iorodeo/iorodeo_feather_tripler_enc1/README.md

# IO Rodeo's iorodeo_feather_tripler_enc1  

Hardware files for IO Rodeo's iorodeo_feather_tripler_enc1. (In progress)

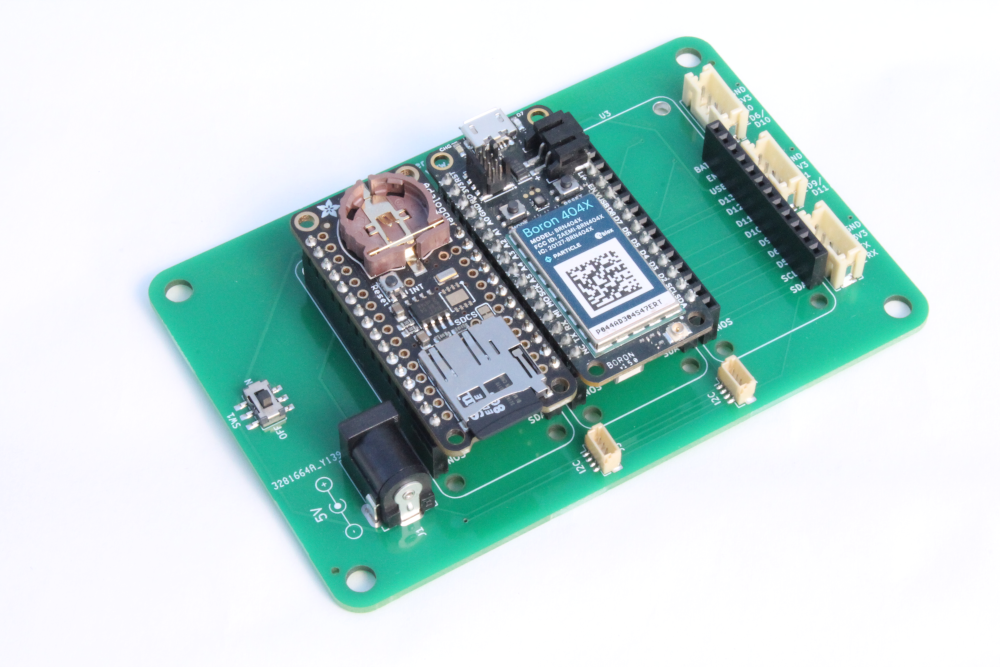
[picture p1: images/feather_tripler_pcb_adalogger_boron_1.png]
Feather Tripler Enc1 Image #1
