iorodeo/iorodeo_feather_tripler_enc1/images/feather_tripler_enclosure_2.png

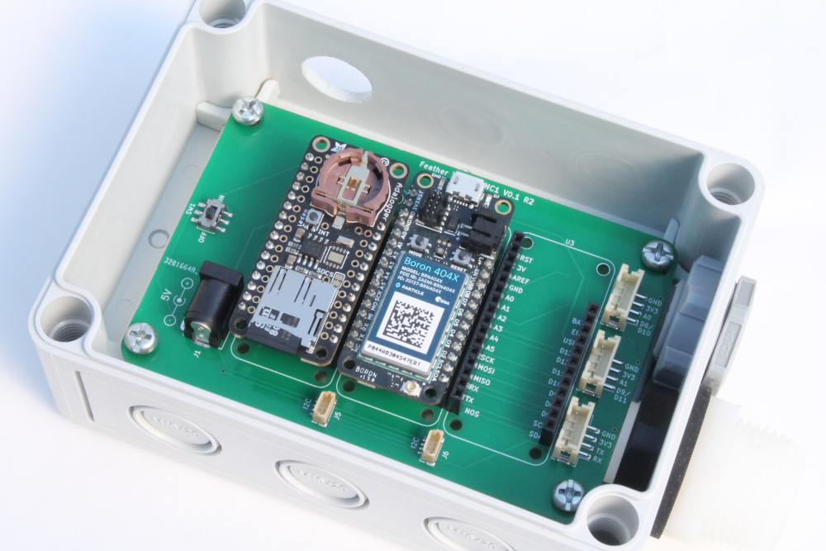
images/feather_tripler_enclosure_2.png
