iorodeo/iorodeo_feather_tripler_enc1/images/feather_tripler_enclosure_3.png

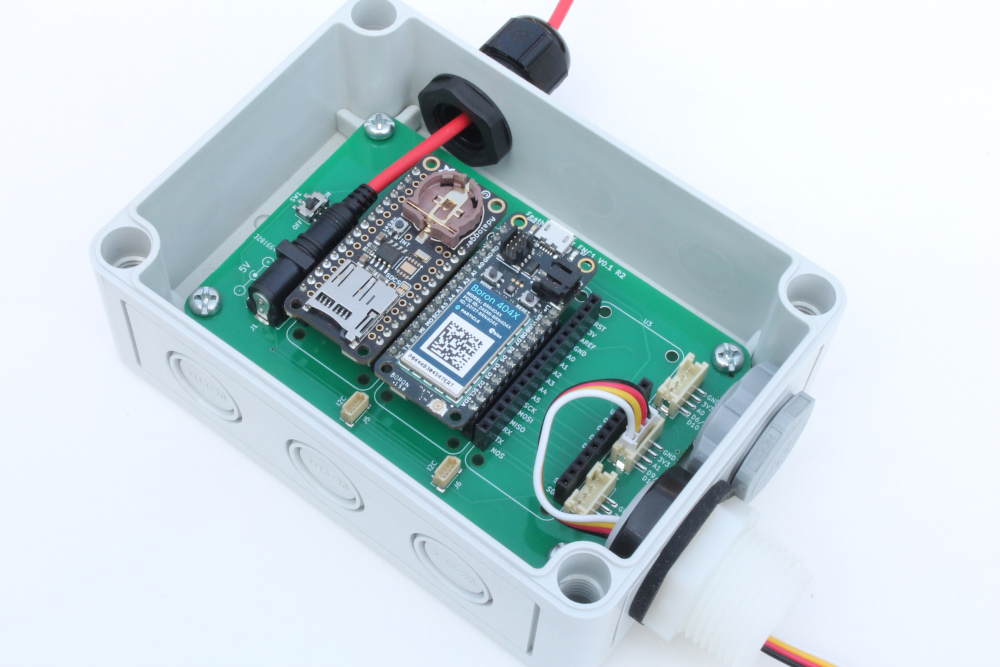
images/feather_tripler_enclosure_3.png
