iorodeo/iorodeo_feather_tripler_enc1/images/feather_tripler_pcb_front_1.png

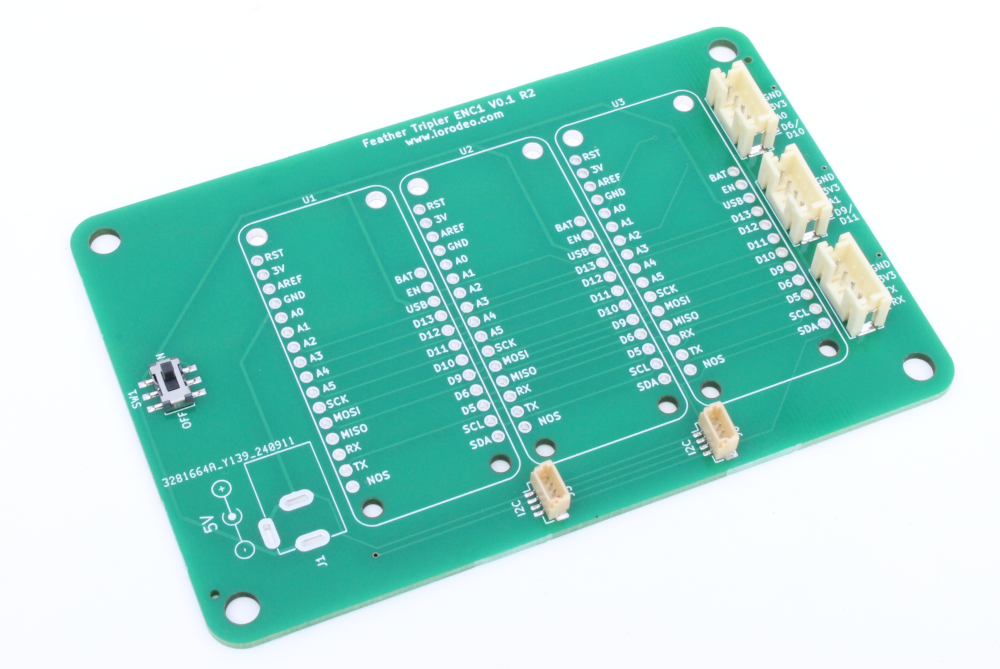
images/feather_tripler_pcb_front_1.png
