iorodeo/iorodeo_feather_tripler_enc1/kicad/BOM.xlsx

Feather Tripler PCB through hole components (hand solder) | Notes | Category | Vendor | Part # | Quantity | URL
Feather Header Kit | female headers for mounting feather/featherwings | Tripler PCB | Adafruit | 2886 | 3 | https://www.adafruit.com/product/2886
DC Power Connector | for connecting power from solar panel | Tripler PCB | Mouser | 490-PJ-035C | 1 | https://www.mouser.com/ProductDetail/490-PJ-035C
Feather Tripler PCB through SMT components (pre-assembled) * | Notes | Category | Vendor | Part # | Quantity | URL
PCB Switch | smt power switch | Tripler PCB | LCSC | C963205 | 1 | https://www.lcsc.com/product-detail/Slide-Switches_G-Switch-MS-22D28-G020_C963205.html
JST PH vertical 4-pin | Grove connectors | Tripler PCB | LCSC | C160354 | 3 | https://www.lcsc.com/product-detail/Wire-To-Board-Connector_JST-B4B-PH-SM4-TB-LF-SN_C160354.html
JST SH vertical 4-pin | stemma/qwiic connectors | Tripler PCB | LCSC | C160390 | 2 | https://www.lcsc.com/product-detail/Wire-To-Board-Connector_JST-BM04B-SRSS-TB-LF-SN_C160390.html
Polycase enclosure parts | Notes | Category | Vendor | Part # | Quantity | URL
SK-15 Enclosure with Knockouts | enclosure for electronics | Polycase | Polycase | SK-15-02 | 1 | https://www.polycase.com/sk-15
SK-99 Mounting Kit for SK Series Enclosures | feet for mounting enclosure | Polycase | Polycase | SK-99 | 1 | https://www.polycase.com/sk-99
SK-97 Spacer Kit for SK Series Enclosures | spacer kit for mounting PCB inside enclosure | Polycase | Polycase | SK-97 | 1 | https://www.polycase.com/sk-97
Vent Plug |  | Polycase | Polycase | UA-006 | 1 | https://www.polycase.com/ua-006
External solar power | Notes | Category | Vendor | Part # | Quantity | URL
5 Watt 5 Volt 35Wh Solar System | voltaic solar panel/battery combo | Electronics | Voltaic | K-P105-V35IoT | 1 | https://voltaicsystems.com/5-watt-5-volt-35wh-solar-system/
Plastic Submersible Cord Grip for 0.13"-0.27" Cord OD, for M16 Knockout | waterproof cable entry | Polycase | mcmaster | 7310K52 | 1 | https://www.mcmaster.com/7310K52/
Compatible cables (examples) | Notes | Category | Vendor | Part # | Quantity | URL
Grove cable, 4pos, 20cm, 5pack | used to connect sensors with analog output, e.g., maxsonar to PCB | Tripler PCB | Digikey | 2221-A034-B-ND | 1 | https://www.digikey.com/en/products/detail/m5stack-technology-co-ltd/A034-B/16370068
Stemma Qt/Qwiic cable 50mm long | used for optional i2c sensors | Tripler PCB | Adafruit | 4399 | 1 | https://www.adafruit.com/product/4399
Additional parts for Open water level sensor (https://github.com/COAST-Lab/Open-Water-Level) | Notes | Category | Vendor | Part # | Quantity | URL
Maxbotix Ultrasonic Rangefinder MB7092 XL-MaxSonar-WRMA1 | distance sensor | Electronics | Adafruit | 1137 | 1 | https://www.adafruit.com/product/1137
Adalogger RTC + SD Add-on For All Feather Boards | for data logging | Electronics | Adafruit | 2922 | 1 | https://www.adafruit.com/product/2922
SD/MicroSD Memory Card (8 GB SDHC) | disk for data logging | Electronics | Adafruit | 1294 | 1 | https://www.adafruit.com/product/1294
BORON LTE CAT-M1 (NORAM) WITH ET | MCU, cell modem, power management, cellular communications | Electronics | Digikey | 1878-BRN404X-ND | 1 | https://www.digikey.com/en/products/detail/particle-industries-inc/BRN404X/17632424
Plastic pipe fitting straight connector with hex body, 3/4 NPT Female | for mounting sonar to polycase enclosure | Polycase | mcmaster | 48335K143 | 1 | https://www.mcmaster.com/48335K143/
Plastic pipe fitting reducer with hex nody, 3/4 NPT male x 1/2 NPT male | for mounting sonar to polycase enclosure | Polycase | mcmaster | 48335K167 | 1 | https://www.mcmaster.com/48335K167/
1/2 NPT black locknut for continuous-flex Plastic conduit fitting | for mounting sonar to polycase enclosure | Polycase | mcmaster | 3185K112 | 1 | https://www.mcmaster.com/3185K112/
Gasket Washer, $7.22 pack of 25 | for mounting sonar to polycase enclosure | Polycase | mcmaster | 5456K21 | 1 | https://www.mcmaster.com/5456K21/
IO Rodeo XL MaxSonar adapter PCB ** | for connecting cable to sonar distance sensor |  | IO Rodeo |  | 1 | https://github.com/iorodeo/xl_maxsonar_adapter
* gerber and fab files for automated assembly can be found in the “kicad/produciton” sub-directory.
** see xl_maxsonar_adapter repository for adapter PCB BOM
