iorodeo/iorodeo_feather_tripler_enc1/kicad/production/v0p1_r1/BOM_JLCPCB_feather_tripler_enc1_v0p1r1.xlsx

Comment | Designator | Footprint | LCSC Part #（optional） | Qty
SMD Slide Switch | SW1 | SMD | C963205 | 1
JST PH 4-pin connector vertical, B4B-PH-SM4-TB(LF)(SN) | J2,J3,J4 | SMD,P=2mm | C160354 | 3
JST SH 4-pin connector vertical, BM04B-SRSS-TB(LF)(SN) | J5,J6 | SMD,P=1mm | C160390 | 2
