iorodeo/iorodeo_feather_tripler_enc1/kicad/iorodeo_feather_tripler_enc1.step

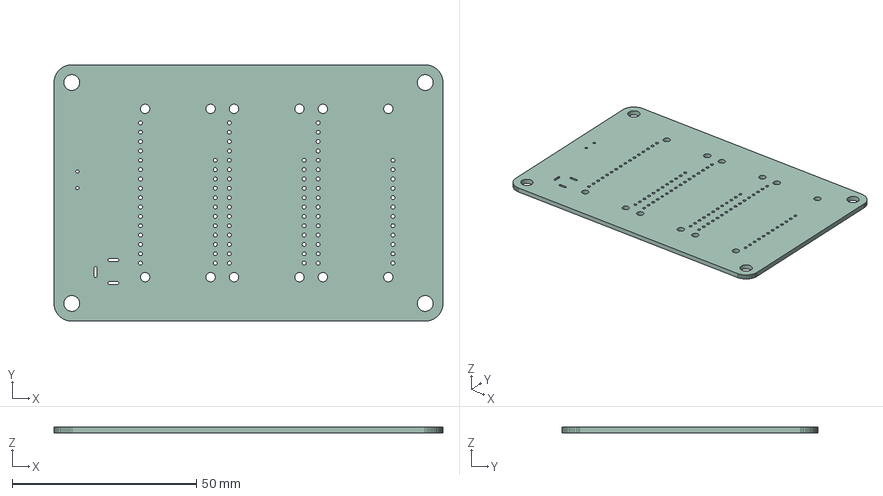
[picture p8: CAD file, 2024-09-08]
kicad/iorodeo_feather_tripler_enc1.step
105.7 x 69.6 x 1.60 mm
