iorodeo/iorodeo_feather_tripler_enc1/(list of files, drawings)

Other design files:
kicad/iorodeo_feather_tripler_enc1.dsn
