iorodeo/iorodeo_feather_tripler_enc1/kicad/iorodeo_feather_tripler_enc1.kicad_pcb

## KiCad design kicad/iorodeo_feather_tripler_enc1.kicad_pcb (2024-09-09)

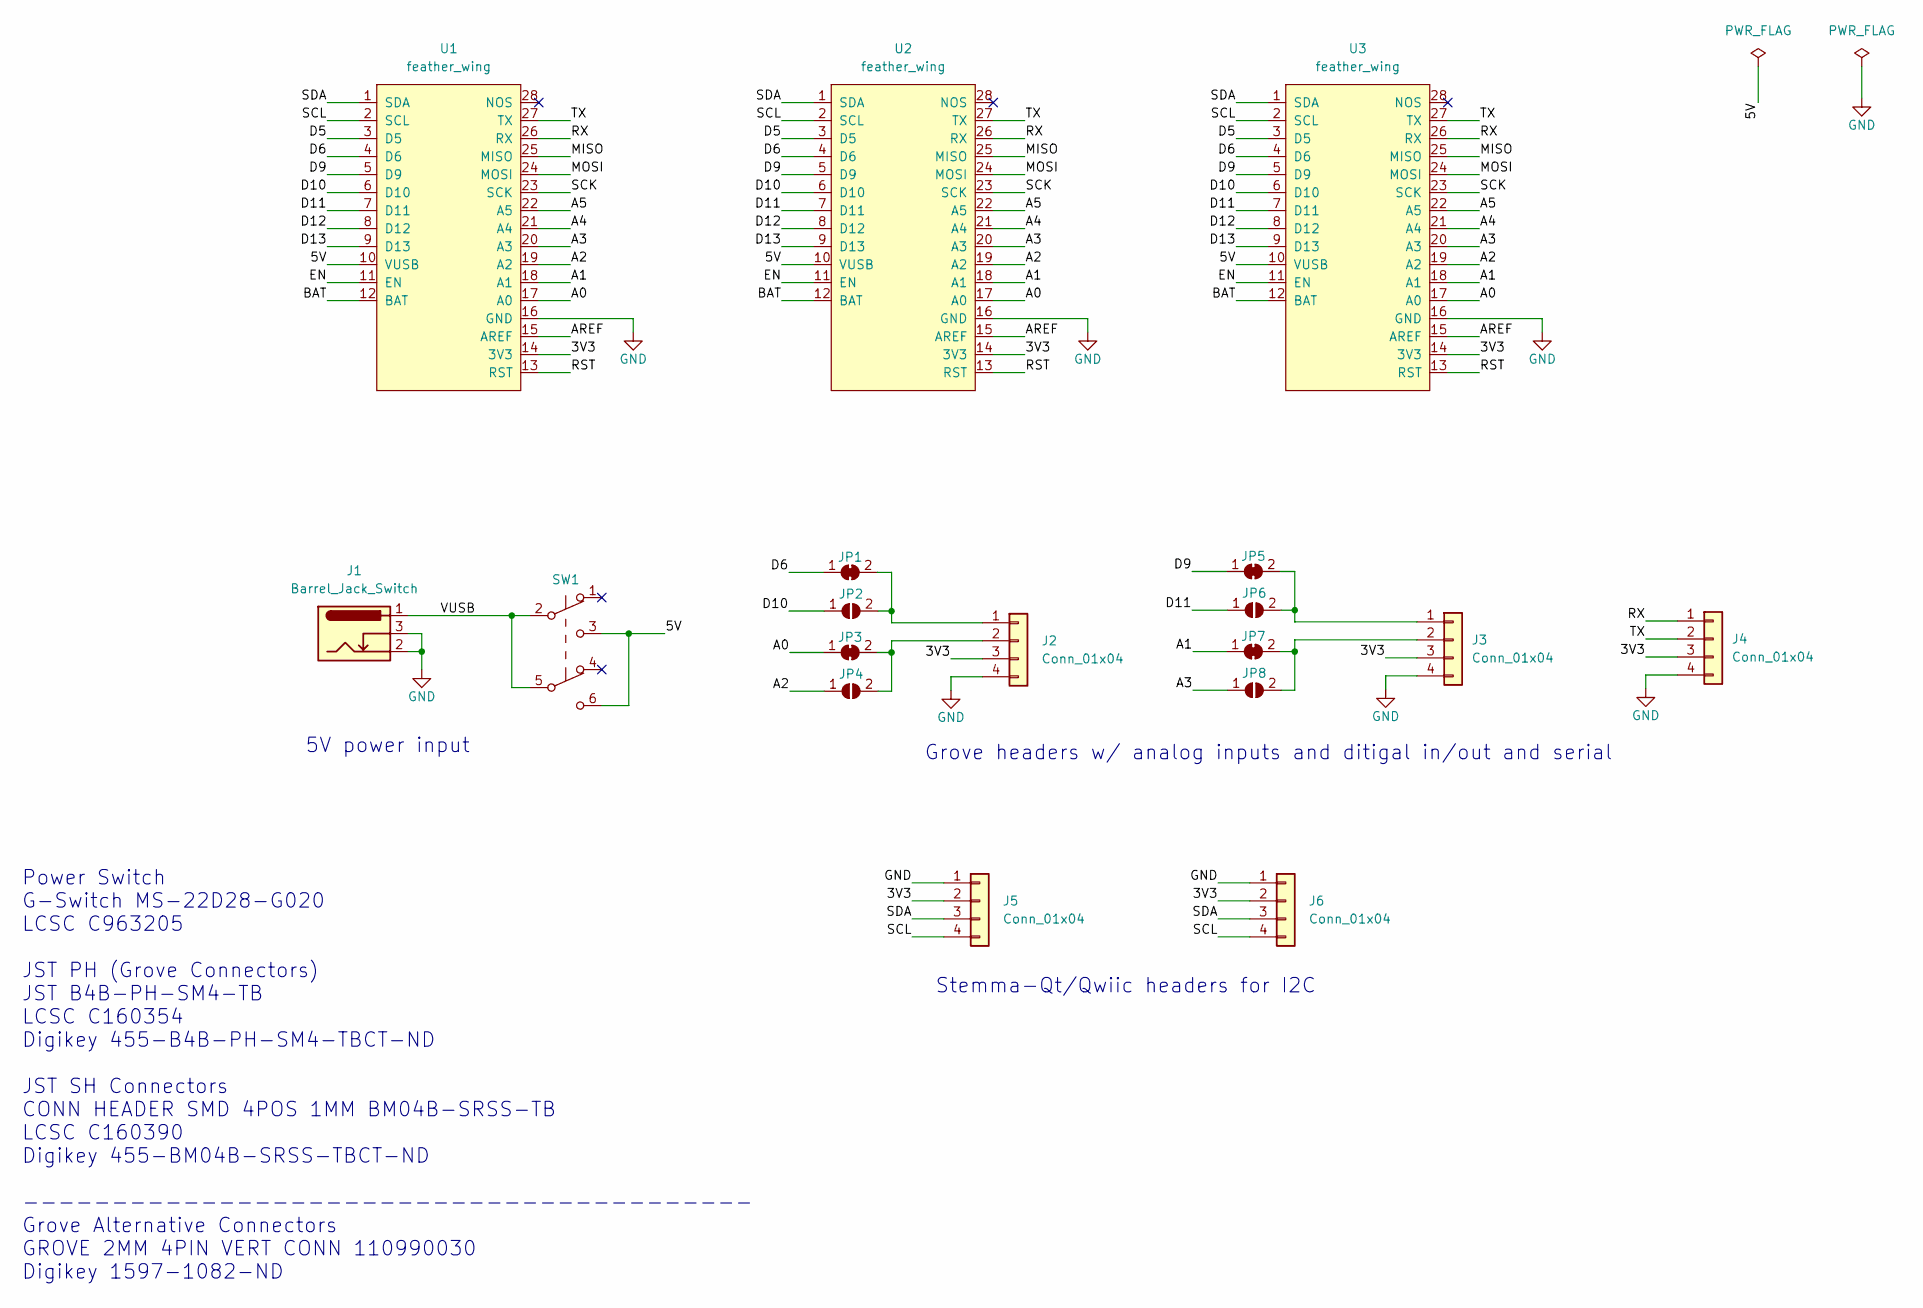
[picture p9: schematic iorodeo_feather_tripler_enc1.kicad_sch]

Parts:
J1: Barrel_Jack_Switch; CUI_PJ-035C
J2, J3, J4: Conn_01x04; JST_PH_B4B-PH-SM4-TB_1x04-1MP_P2.00mm_Vertical
J5, J6: Conn_01x04; JST_SH_BM04B-SRSS-TB_1x04-1MP_P1.00mm_Vertical
JP1, JP3, JP5, JP7: SolderJumper_2_Bridged; SolderJumper-2_P1.3mm_Bridged_RoundedPad1.0x1.5mm
JP2, JP4, JP6, JP8: SolderJumper_2_Open; SolderJumper-2_P1.3mm_Open_RoundedPad1.0x1.5mm
SW1: SW_Push_DPDT; MS-22D28-G020
U1, U2, U3: feather_wing

Connections:
/3V3: J2.3, J3.3, J4.3, J5.2, J6.2, U1.14 (3V3), U2.14 (3V3), U3.14 (3V3)
/5V: SW1.3 (C), SW1.6 (C), U1.10 (VUSB), U2.10 (VUSB), U3.10 (VUSB)
/A0: JP3.1 (A), U1.17 (A0), U2.17 (A0), U3.17 (A0)
/A1: JP7.1 (A), U1.18 (A1), U2.18 (A1), U3.18 (A1)
/A2: JP4.1 (A), U1.19 (A2), U2.19 (A2), U3.19 (A2)
/A3: JP8.1 (A), U1.20 (A3), U2.20 (A3), U3.20 (A3)
/A4: U1.21 (A4), U2.21 (A4), U3.21 (A4)
/A5: U1.22 (A5), U2.22 (A5), U3.22 (A5)
/AREF: U1.15 (AREF), U2.15 (AREF), U3.15 (AREF)
/BAT: U1.12 (BAT), U2.12 (BAT), U3.12 (BAT)
/D5: U1.3 (D5), U2.3 (D5), U3.3 (D5)
/D6: JP1.1 (A), U1.4 (D6), U2.4 (D6), U3.4 (D6)
/D9: JP5.1 (A), U1.5 (D9), U2.5 (D9), U3.5 (D9)
/D10: JP2.1 (A), U1.6 (D10), U2.6 (D10), U3.6 (D10)
/D11: JP6.1 (A), U1.7 (D11), U2.7 (D11), U3.7 (D11)
/D12: U1.8 (D12), U2.8 (D12), U3.8 (D12)
/D13: U1.9 (D13), U2.9 (D13), U3.9 (D13)
/EN: U1.11 (EN), U2.11 (EN), U3.11 (EN)
/MISO: U1.25 (MISO), U2.25 (MISO), U3.25 (MISO)
/MOSI: U1.24 (MOSI), U2.24 (MOSI), U3.24 (MOSI)
/RST: U1.13 (RST), U2.13 (RST), U3.13 (RST)
/RX: J4.1, U1.26 (RX), U2.26 (RX), U3.26 (RX)
/SCK: U1.23 (SCK), U2.23 (SCK), U3.23 (SCK)
/SCL: J5.4, J6.4, U1.2 (SCL), U2.2 (SCL), U3.2 (SCL)
/SDA: J5.3, J6.3, U1.1 (SDA), U2.1 (SDA), U3.1 (SDA)
/TX: J4.2, U1.27 (TX), U2.27 (TX), U3.27 (TX)
/VUSB: J1.1, SW1.2 (B), SW1.5 (B)
GND: J1.2, J1.3, J2.4, J3.4, J4.4, J5.1, J6.1, U1.16 (GND), U2.16 (GND), U3.16 (GND)
unnamed: J2.1, JP1.2 (B), JP2.2 (B)
unnamed: J2.2, JP3.2 (B), JP4.2 (B)
unnamed: J3.1, JP5.2 (B), JP6.2 (B)
unnamed: J3.2, JP7.2 (B), JP8.2 (B)

Notes on the sheet:
Power Switch G-Switch MS-22D28-G020 LCSC C963205 JST PH (Grove Connectors) JST B4B-PH-SM4-TB LCSC C160354 Digikey 455-B4B-PH-SM4-TBCT-ND JST SH Connectors CONN HEADER SMD 4POS 1MM BM04B-SRSS-TB LCSC C160390 Digikey 455-BM04B-SRSS-TBCT-ND ----------------------------------------- Grove Alternative C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
Grove headers w/ analog inputs and ditigal in/out and serial
5V power input
Stemma-Qt/Qwiic headers for I2C

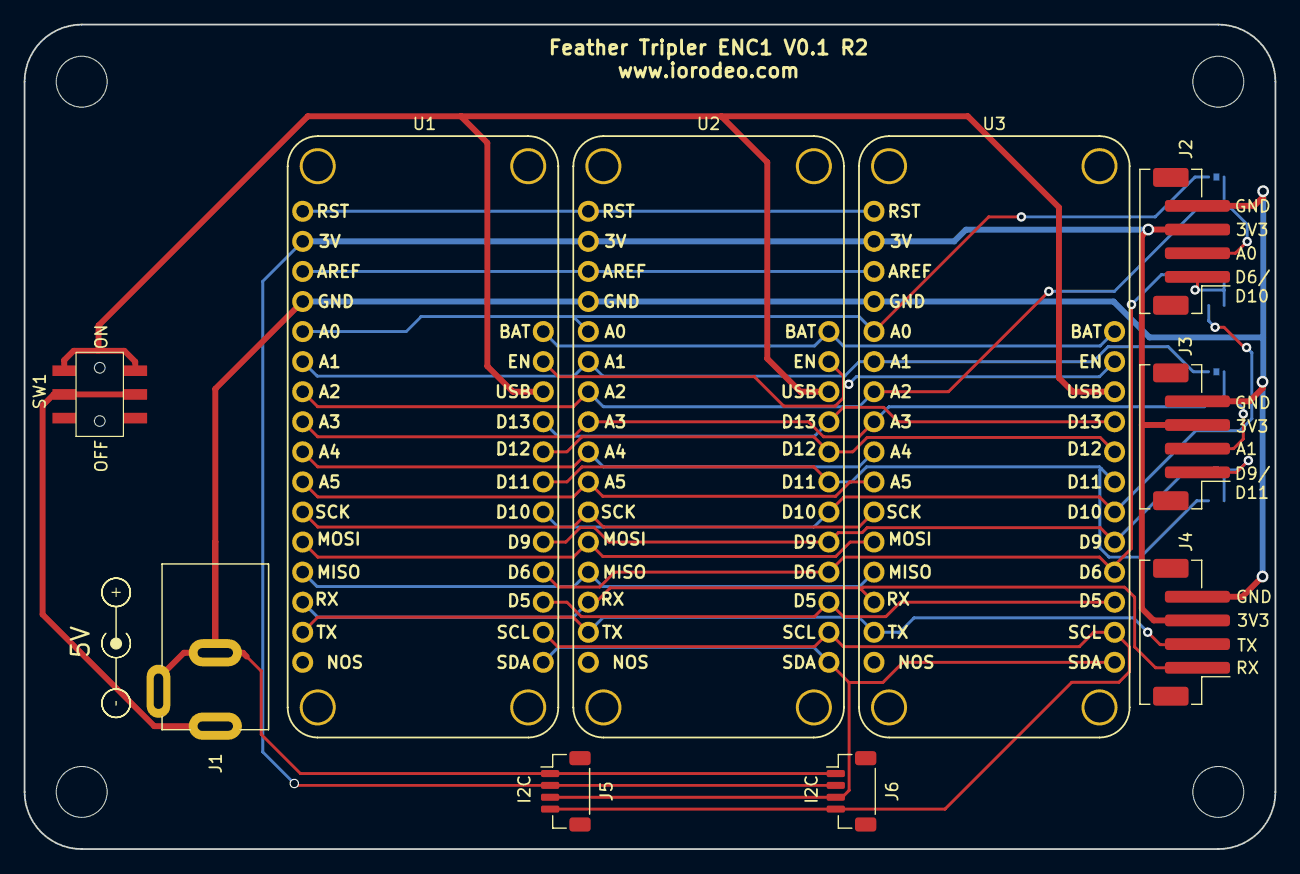
[picture p10: board iorodeo_feather_tripler_enc1.kicad_pcb from above]

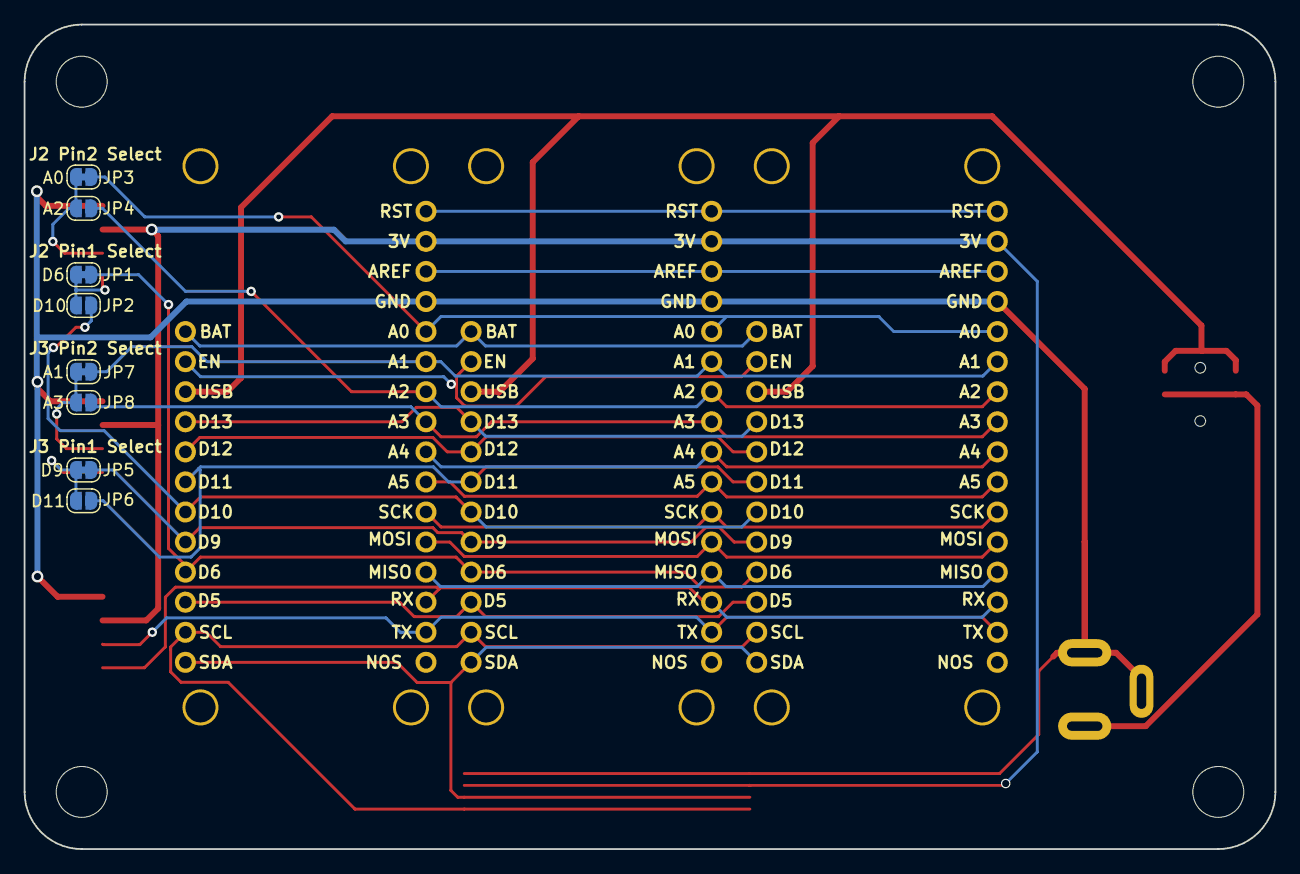
[picture p11: board iorodeo_feather_tripler_enc1.kicad_pcb from below]

Board: 2 copper layers, 105.7 x 69.6 mm, 22 parts (8 on the bottom side), 32 nets.

Other parts of the board:
M1, M2, M3, M4: MountingHole_4.3mm_M4
