iorodeo/iorodeo_feather_tripler_enc1/images/feather_tripler_pcb_assembled_front_1.png

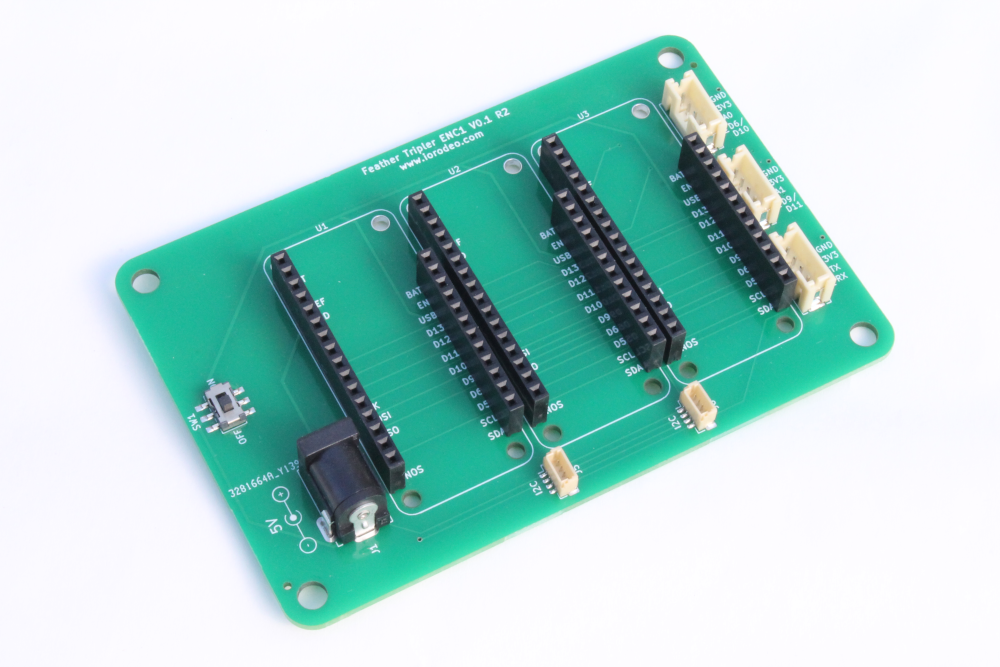
images/feather_tripler_pcb_assembled_front_1.png
