iorodeo/iorodeo_feather_tripler_enc1/(commit log)

2024-08-19 Project creation.
    [BOM_JLCPCB_feather_tripler_enc1_v0p1r1.xlsx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]
2024-08-19 Fixed issues with JST PH header orientation.
    [CPL_JLCPCB_feather_tripler_enc1_v0p1r1.xlsx, iorodeo_feather_tripler_enc1-B_Cu.gbr, iorodeo_feather_tripler_enc1-B_Mask.gbr, iorodeo_feather_tripler_enc1-B_Paste.gbr, iorodeo_feather_tripler_enc1-B_Silkscreen.gbr, iorodeo_feather_tripler_enc1-Edge_Cuts.gbr, iorodeo_feather_tripler_enc1-F_Cu.gbr, iorodeo_feather_tripler_enc1-F_Mask.gbr]
2024-09-04 Added an image folder and image of PCB v0.1 R1
2024-09-08 Worked on revision 2.
    [iorodeo_feather_tripler_enc1.kicad_pcb, iorodeo_feather_tripler_enc1.kicad_sch]
2024-09-08 More work on revision 2. Added jumper pads to grove headers.
    [iorodeo_feather_tripler_enc1.kicad_pcb, iorodeo_feather_tripler_enc1.kicad_sch]
2024-09-08 Assigned footprints for jumper pads.
    [iorodeo_feather_tripler_enc1.kicad_sch]
2024-09-08 Finished rerouting board. Remade production files. Need to be checked.
    [BOM_JLCPCB_feather_tripler_enc1_v0p1r1.xlsx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]
2024-09-09 Fixed issues in silkscreen. Remade gerbers.
    [iorodeo_feather_tripler_enc1-B_Cu.gbr, iorodeo_feather_tripler_enc1-B_Mask.gbr, iorodeo_feather_tripler_enc1-B_Paste.gbr, iorodeo_feather_tripler_enc1-B_Silkscreen.gbr, iorodeo_feather_tripler_enc1-Edge_Cuts.gbr, iorodeo_feather_tripler_enc1-F_Cu.gbr, iorodeo_feather_tripler_enc1-F_Mask.gbr, iorodeo_feather_tripler_enc1-F_Paste.gbr]
2024-09-09 Fixed another issue in silkscreen and remade gerbers.
    [iorodeo_feather_tripler_enc1-B_Cu.gbr, iorodeo_feather_tripler_enc1-B_Mask.gbr, iorodeo_feather_tripler_enc1-B_Paste.gbr, iorodeo_feather_tripler_enc1-B_Silkscreen.gbr, iorodeo_feather_tripler_enc1-Edge_Cuts.gbr, iorodeo_feather_tripler_enc1-F_Cu.gbr, iorodeo_feather_tripler_enc1-F_Mask.gbr, iorodeo_feather_tripler_enc1-F_Paste.gbr]
2024-09-29 Added project BOM.
    [BOM.xlsx]
2024-09-29 Cleaned up a bit.
    [BOM.xlsx, BOM_JLCPCB_feather_tripler_enc1_v0p1r1.xlsx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]
2024-10-02 Added PCB and enclosure images.
